AnaviTechnology/anavi-smiley/(commit log)

2020-01-23 anavi-smiley.kicad_pcb: Adjust texts
    [anavi-smiley.kicad_pcb]
2020-01-23 anavi-smiley.kicad_pcb: Move connector down
    [anavi-smiley.kicad_pcb]
2020-01-23 anavi-smiley.kicad_pcb: Move R1
    [anavi-smiley.kicad_pcb]
2020-01-24 anavi-smiley.kicad_pcb: Add year
    Add year to the front silkscreen.
    [anavi-smiley.kicad_pcb]
2020-01-24 Remove silkscreen from the 4 pin header
    Modify the footprint and save it to a local library, update
    it in the PCB view.
    [anavi-smiley.kicad_pcb]
