AnaviTechnology/anavi-smiley/(notices)

Notices in the files:
anavi-smiley.kicad_pcb:
Rev 1.0 (c) 2020
